neherh/Wall_Follow_Code/slamParts/table assembly.SLDASM

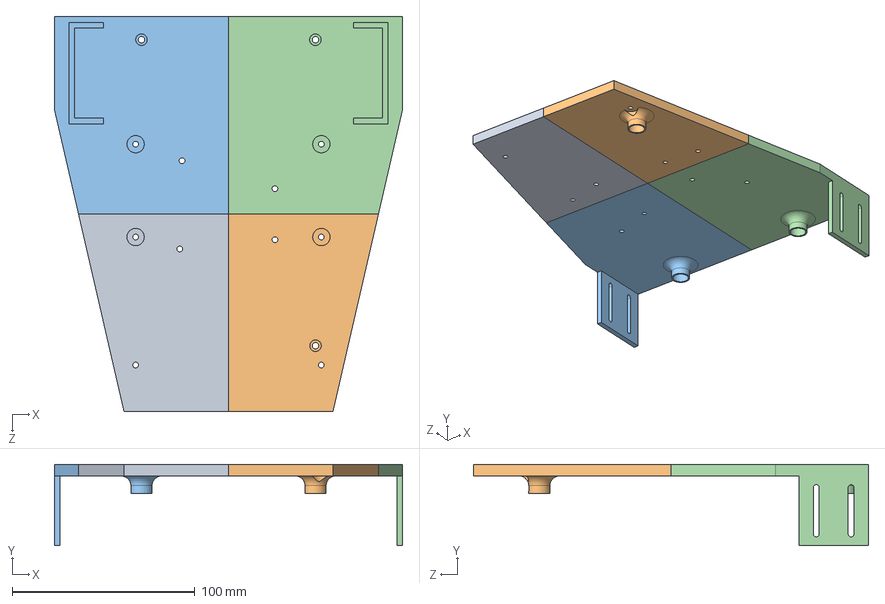
[picture p1: CAD file, 2016-04-07]
slamParts/table assembly.SLDASM
190.5 x 44.4 x 216.1 mm
table part 2
table part 3
table part 4
