neherh/Wall_Follow_Code/slamParts/encodermounts.SLDASM

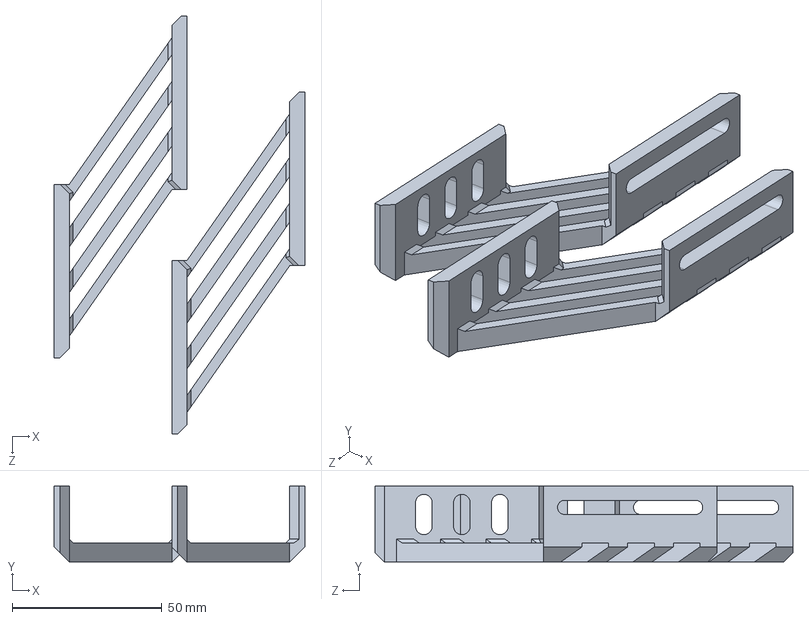
[picture p2: CAD file, 2016-04-07]
slamParts/encodermounts.SLDASM
83.8 x 25.4 x 139.7 mm
encodermount x 2
