neherh/Wall_Follow_Code/slamParts/mountsandshafts.SLDASM

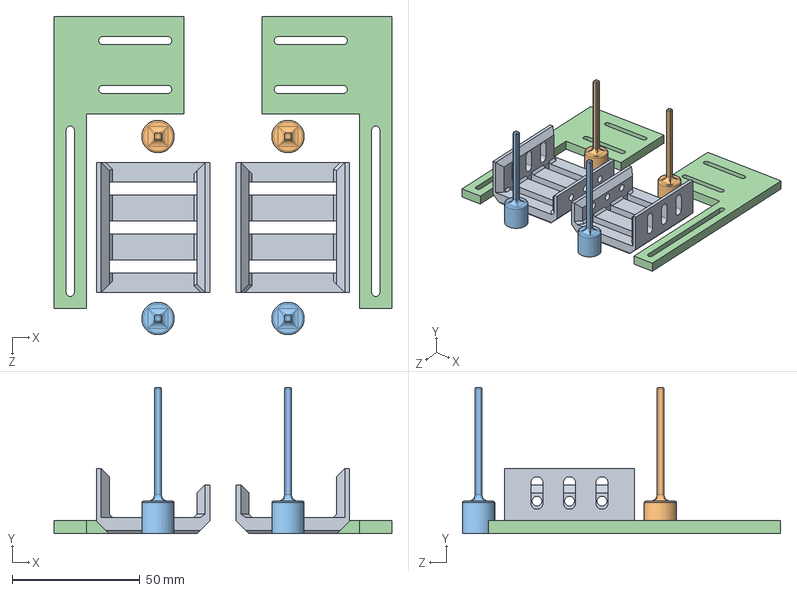
[picture p3: CAD file, 2016-04-07]
slamParts/mountsandshafts.SLDASM
132.1 x 57.1 x 124.5 mm
encodermounts
encodershaft x 2
encodershaftid x 2
encodermountnew1 x 2
