neherh/Wall_Follow_Code/slamParts/encodermountnew1.SLDPRT

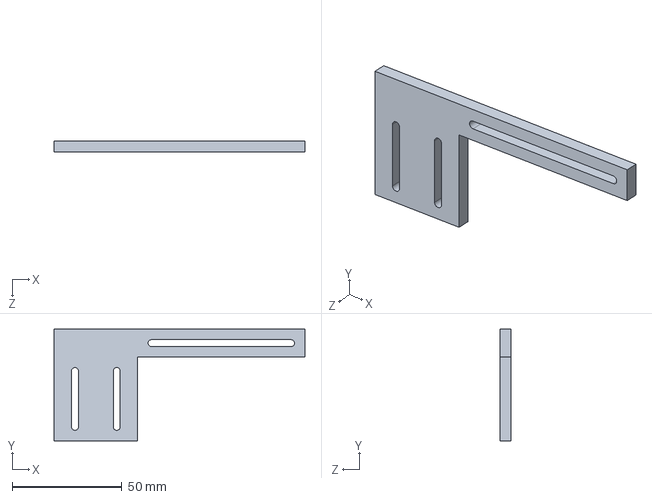
[picture p4: CAD file, 2016-04-07]
slamParts/encodermountnew1.SLDPRT
114.3 x 50.8 x 5.08 mm
