neherh/Wall_Follow_Code/slamParts/encodermount.SLDPRT

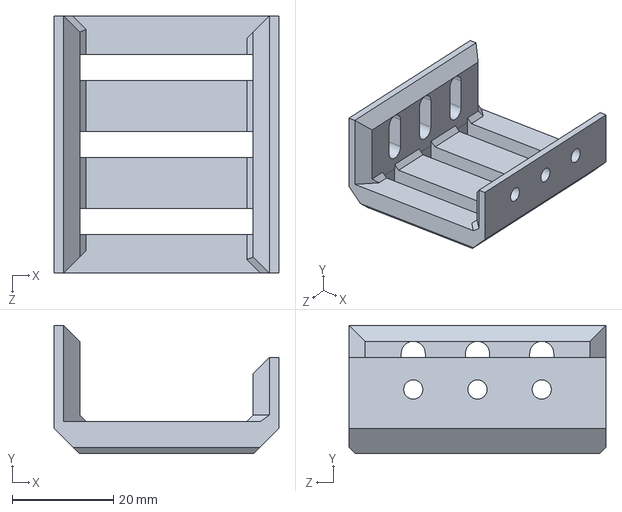
[picture p5: CAD file, 2016-04-07]
slamParts/encodermount.SLDPRT
44.5 x 25.4 x 50.8 mm
