neherh/Wall_Follow_Code/slamParts/holder.SLDPRT

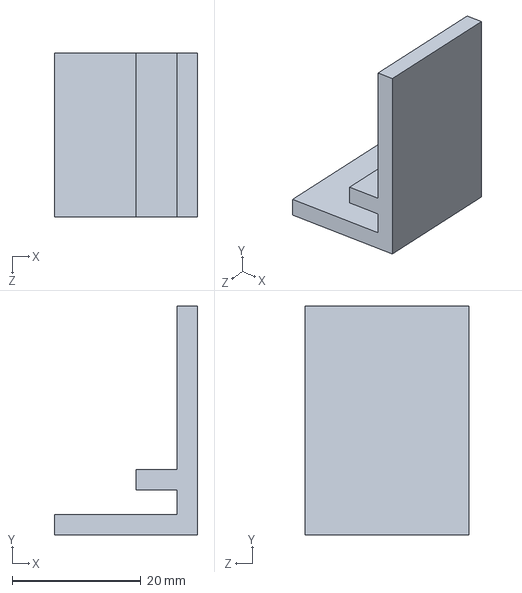
[picture p6: CAD file, 2016-04-07]
slamParts/holder.SLDPRT
22.2 x 35.6 x 25.4 mm
