neherh/Wall_Follow_Code/slamParts/battery holder.SLDPRT

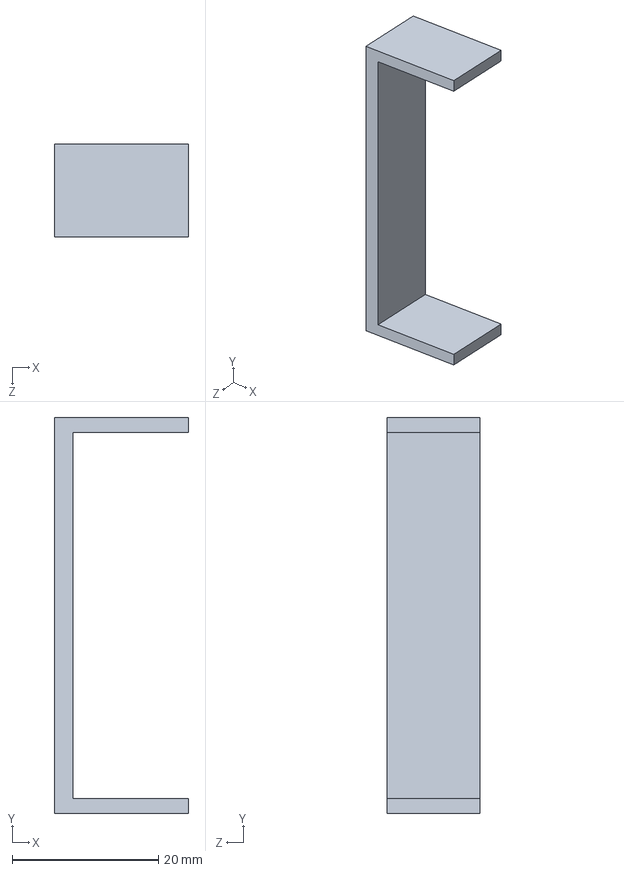
[picture p7: CAD file, 2016-04-07]
slamParts/battery holder.SLDPRT
18.4 x 54.2 x 12.7 mm
