neherh/Wall_Follow_Code/slamParts/laptop frame.SLDPRT

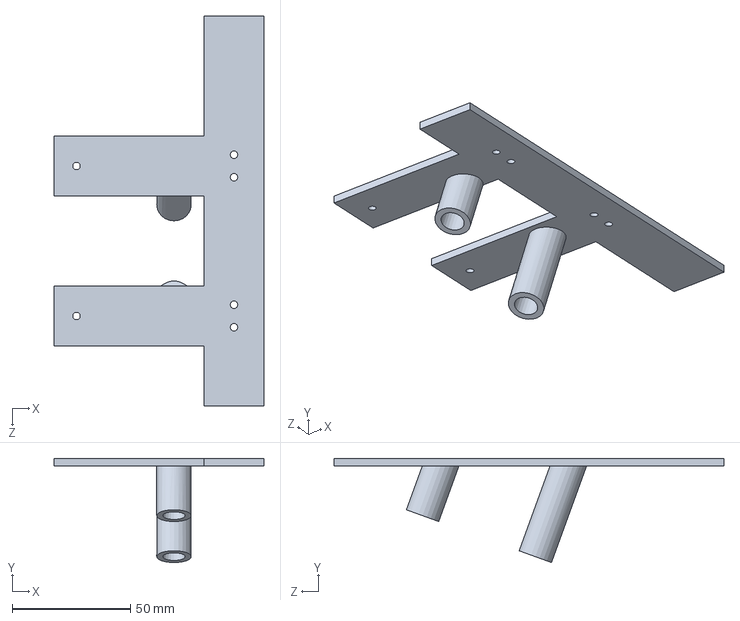
[picture p8: CAD file, 2016-04-07]
slamParts/laptop frame.SLDPRT
88.9 x 44.1 x 165.1 mm
