neherh/Wall_Follow_Code/slamParts/encodershaft.SLDPRT

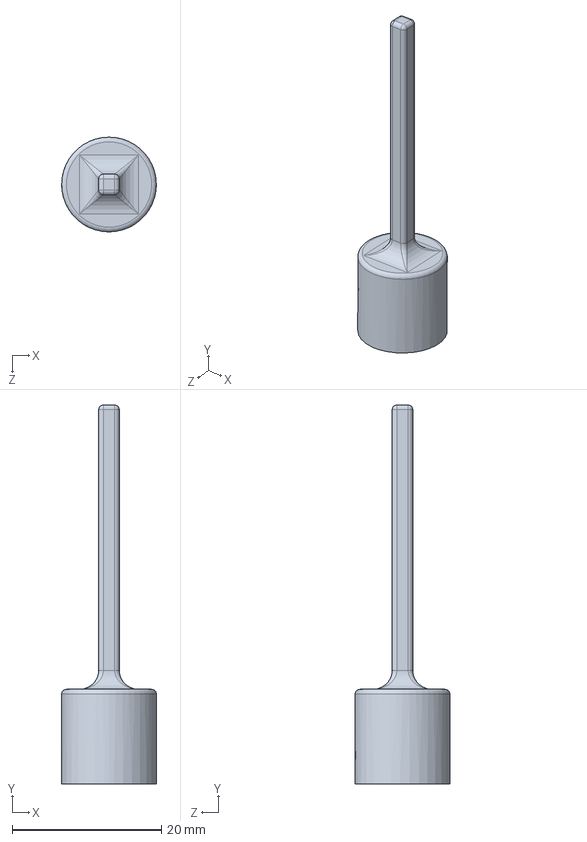
[picture p9: CAD file, 2016-04-07]
slamParts/encodershaft.SLDPRT
12.7 x 50.8 x 12.7 mm
