neherh/Wall_Follow_Code/slamParts/strut2.SLDPRT

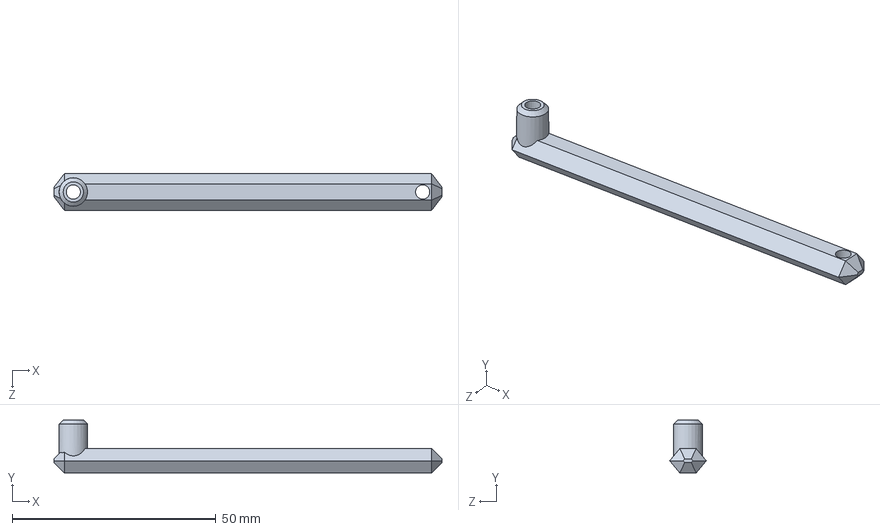
[picture p10: CAD file, 2016-04-07]
slamParts/strut2.SLDPRT
95.2 x 13.0 x 9.00 mm
