neherh/Wall_Follow_Code/slamParts/Larger peg.SLDPRT

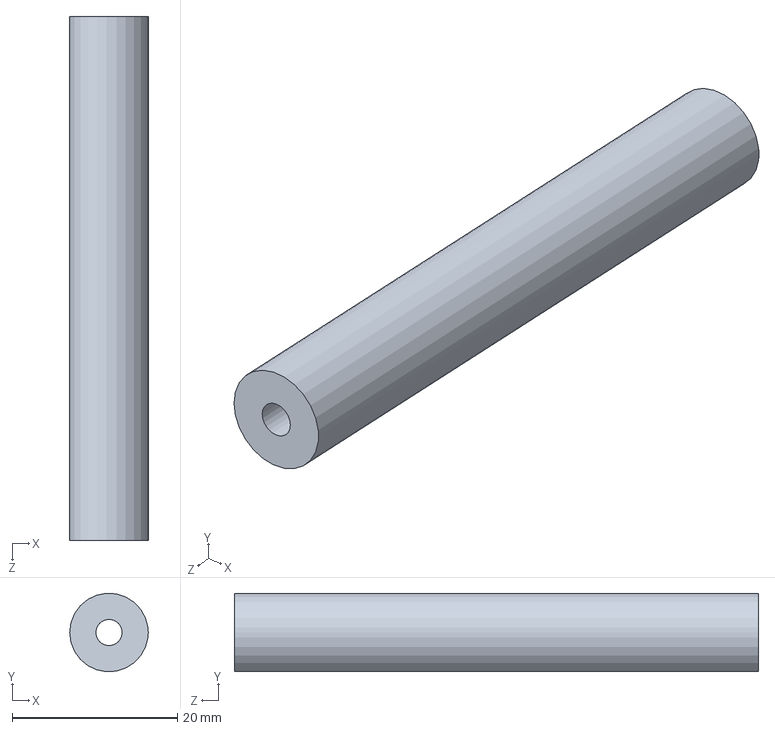
[picture p11: CAD file, 2016-04-07]
slamParts/Larger peg.SLDPRT
9.53 x 9.51 x 63.5 mm
