neherh/Wall_Follow_Code/slamParts/kinect holder2.SLDPRT

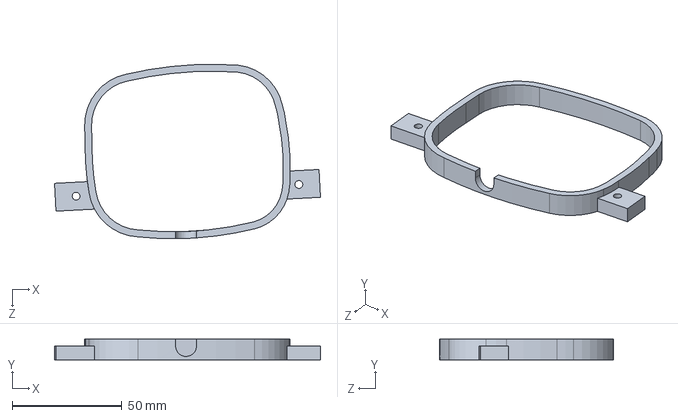
[picture p12: CAD file, 2016-04-07]
slamParts/kinect holder2.SLDPRT
121.1 x 9.53 x 79.4 mm
