neherh/Wall_Follow_Code/slamParts/strut2four.SLDPRT

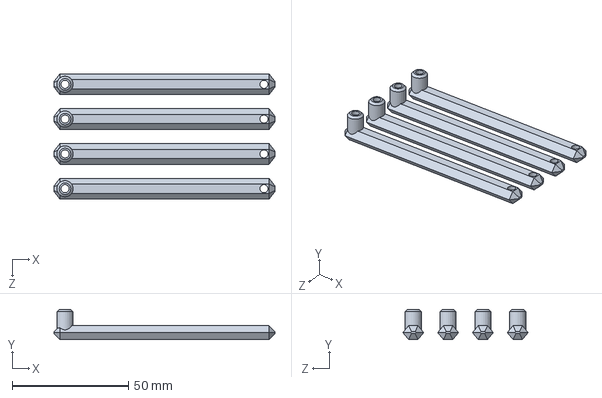
[picture p13: CAD file, 2016-04-07]
slamParts/strut2four.SLDPRT
95.2 x 13.0 x 54.0 mm
