neherh/Wall_Follow_Code/slamParts/laptop holder part2.SLDPRT

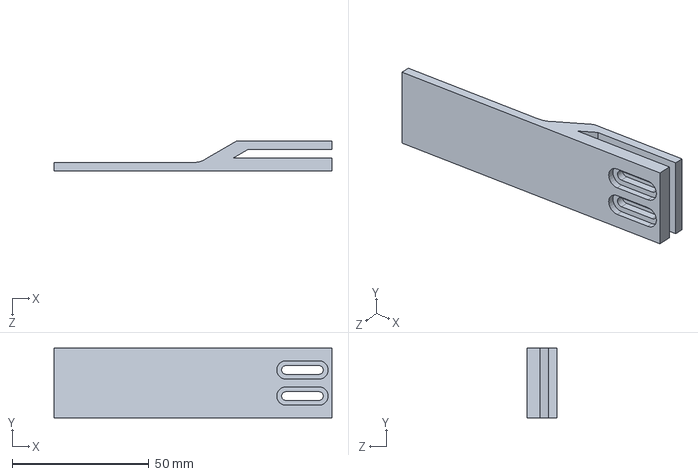
[picture p14: CAD file, 2016-04-07]
slamParts/laptop holder part2.SLDPRT
101.6 x 25.4 x 11.1 mm
