neherh/Wall_Follow_Code/slamParts/smaller pin.SLDPRT

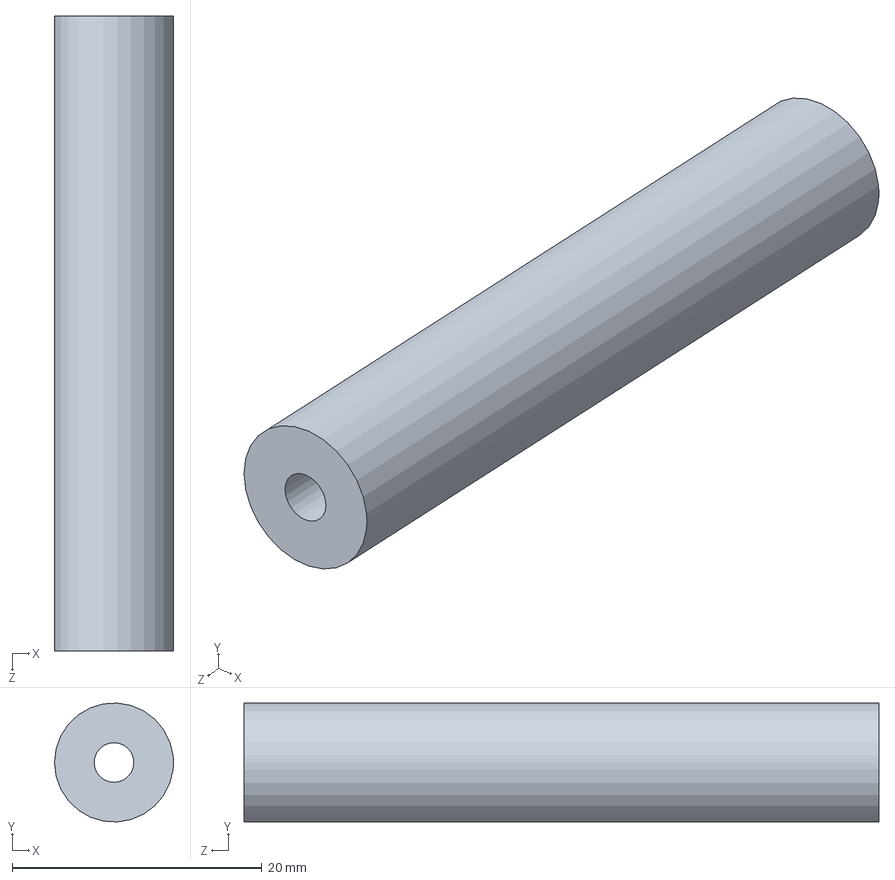
[picture p15: CAD file, 2016-04-07]
slamParts/smaller pin.SLDPRT
9.53 x 9.51 x 50.8 mm
