neherh/Wall_Follow_Code/slamParts/encodershaftid.SLDPRT

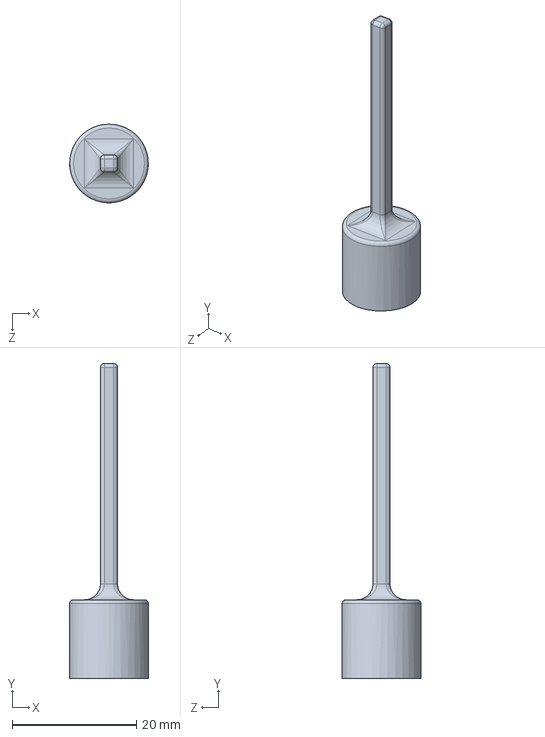
[picture p16: CAD file, 2016-04-07]
slamParts/encodershaftid.SLDPRT
12.7 x 50.8 x 12.7 mm
