neherh/Wall_Follow_Code/(list of files, cad)

Other CAD files:
slamParts/laptop frame again.SLDPRT
