neherh/Wall_Follow_Code/(commit log)

2016-04-07 added arduino and ros directories
2016-04-07 add slamParts directory and associated SolidWorks files
    [Larger peg.SLDPRT, battery holder.SLDPRT, encodermount.SLDPRT, encodermountnew1.SLDPRT, encodermounts.SLDASM, encodershaft.SLDPRT, encodershaftid.SLDPRT, holder.SLDPRT]
